TinkerTechLLC/MBML_control_board/mbml.brd

## EAGLE design mbml.brd (2017-07-24)

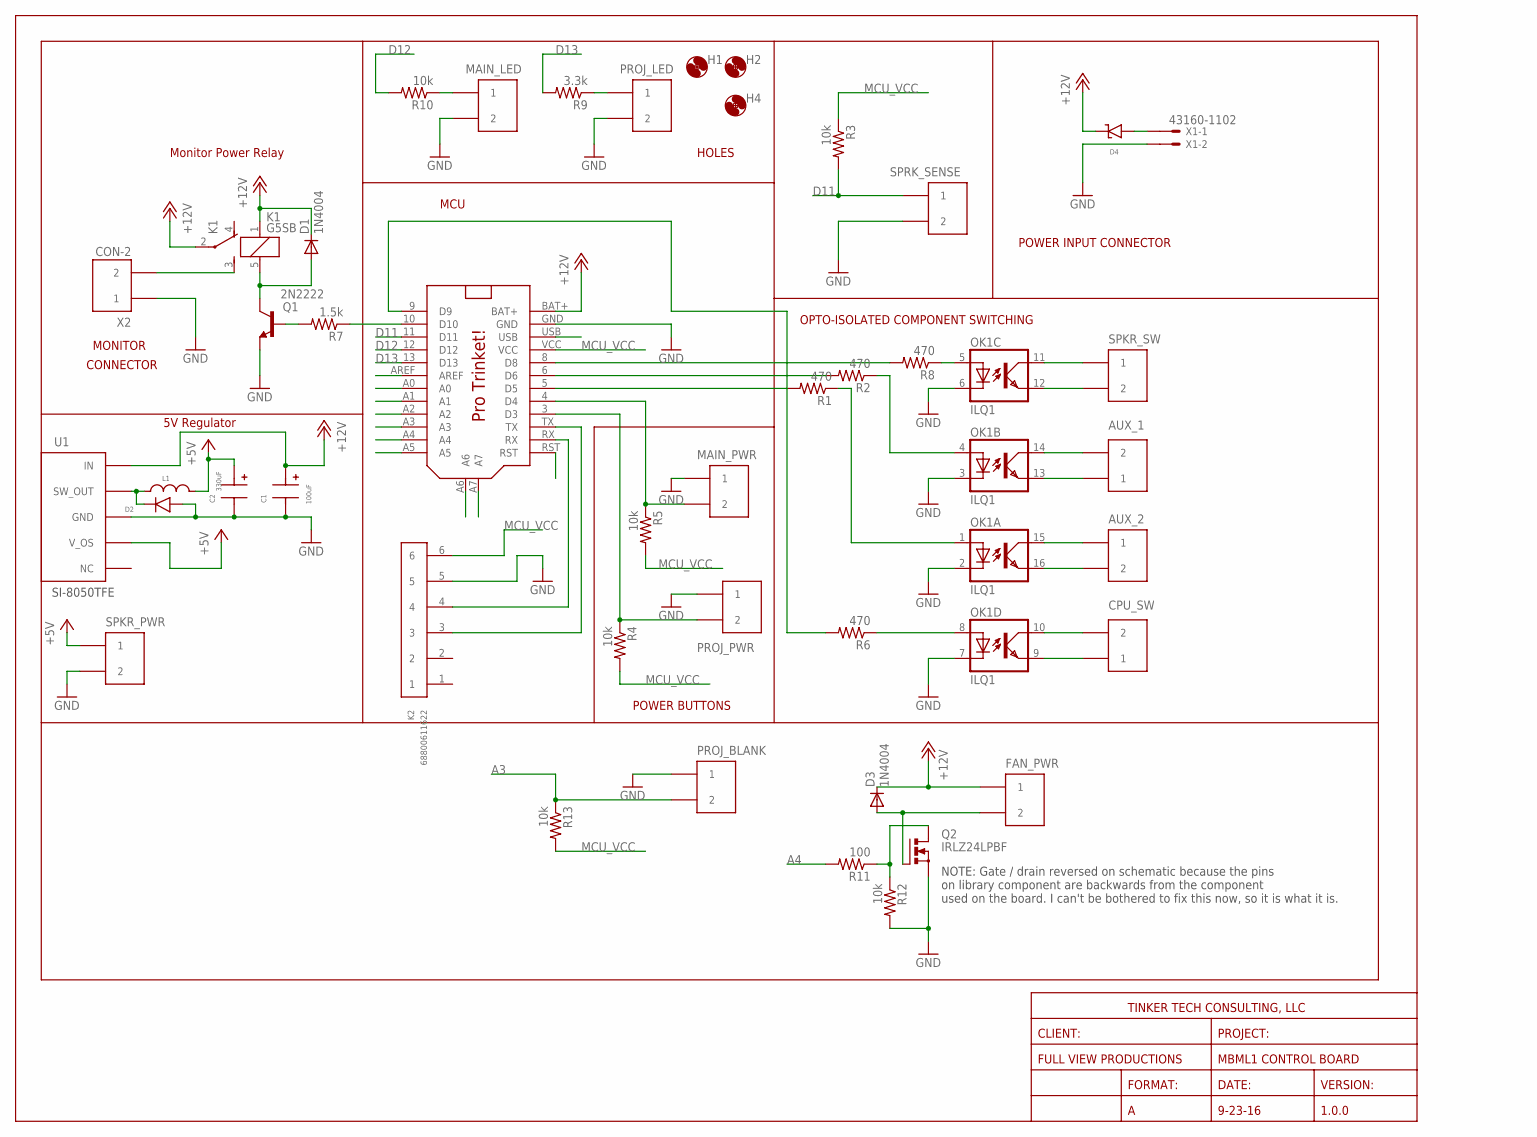
[picture p1: schematic mbml.sch]

Parts:
AUX_1, AUX_2: CON-2B2B-XH-A(LF)(SN); CON_2-2.5MM_TH
C1: 100uF; RADIAL_POL_6.3-DIA_2.5-SPACE
C2: 330uF; RADIAL_POL_10-DIA_5-SPACE
CPU_SW: CON-2B2B-XH-A(LF)(SN); CON_2-2.5MM_TH
D1, D3: 1N4004; DO41-10
D2: DIODE; DO-201AD_AXIAL
D4: DIODE_SHOTTKY; DO-201AD_AXIAL
FAN_PWR: CON-2B2B-XH-A(LF)(SN); CON_2-2.5MM_TH
H1, H2, H4: MOUNT-HOLE3.0; 3,0
K1: G5SB
K2: 68800611622
L1: INDUCTORRADIAL_8.5-DIA_5-SPACE; RADIAL_8.5-DIA_5-SPACE
MAIN_LED: CON-2B2B-XH-A(LF)(SN); CON_2-2.5MM_TH
MAIN_PWR: CON-2B2B-XH-A(LF)(SN); CON_2-2.5MM_TH
OK1: ILQ1; DIL16
PROJ_BLANK: CON-2B2B-XH-A(LF)(SN); CON_2-2.5MM_TH
PROJ_LED: CON-2B2B-XH-A(LF)(SN); CON_2-2.5MM_TH
PROJ_PWR: CON-2B2B-XH-A(LF)(SN); CON_2-2.5MM_TH
Q1: 2N2222; TO18
Q2: IRLZ24LPBF; TO262-V
R1, R2, R6, R8: 470; 0204/5
R3, R4, R5, R10, R12, R13: 10k; 0204/5
R7: 1.5k; 0204/5
R9: 3.3k; 0204/5
R11: 100; 0204/5
SPKR_PWR: CON-2B2B-XH-A(LF)(SN); CON_2-2.5MM_TH
SPKR_SW: CON-2B2B-XH-A(LF)(SN); CON_2-2.5MM_TH
SPRK_SENSE: CON-2B2B-XH-A(LF)(SN); CON_2-2.5MM_TH
U1: REG_5V_SWITCHING_SI-8050E; TO220F-5
U$1: PRO_TRINKET; PROTRINKET
X1: 43160-1102; 43160-XX02
X2: CON-2; MOLEX_MEGA-FIT_2

Connections:
+5V: C2.+, L1.P$2, SPKR_PWR.P$1 (1), U1.4 (V_OS)
+12V: C1.+, D1.C, D3.C, D4.-, FAN_PWR.P$1 (1), K1.1, K1.2, U1.1 (IN), U$1.BAT+
+12V_IN: D4.+, X1.1@1
A0: U$1.A0
A1: U$1.A1
A2: U$1.A2
A3: PROJ_BLANK.P$2 (2), R13.1, U$1.A3
A4: R11.2, U$1.A4
A5: U$1.A5
A6: U$1.A6
A7: U$1.A7
AREF: U$1.AREF
D3: PROJ_PWR.P$2 (2), R4.1, U$1.3 (D3)
D4: MAIN_PWR.P$2 (2), R5.1, U$1.4 (D4)
D5: R1.2, U$1.5 (D5)
D6: R2.2, U$1.6 (D6)
D9: R6.2, U$1.9 (D9)
D10: R7.1, U$1.10 (D10)
D11: R3.2, SPRK_SENSE.P$1 (1), U$1.11 (D11)
D12: R10.2, U$1.12 (D12)
D13: R9.2, U$1.13 (D13)
GND: C1.-, C2.-, D2.+, K2.5, MAIN_LED.P$2 (2), MAIN_PWR.P$1 (1), OK1.2 (C), OK1.3 (C), OK1.6 (C), OK1.7 (C), PROJ_BLANK.P$1 (1), PROJ_LED.P$2 (2), PROJ_PWR.P$1 (1), Q1.1 (E), Q2.3 (S), R12.2, SPKR_PWR.P$2 (2), SPRK_SENSE.P$2 (2), U1.3 (GND), U$1.GND, X1.2@1, X2.P$1 (1)
MCU_VCC: K2.6, R3.1, R4.2, R5.2, R13.2, U$1.VCC
MON_PWR: K1.3 (S), X2.P$2 (2)
unnamed: D2.-, L1.P$1, U1.2 (SW_OUT)
unnamed: OK1.5 (A), R8.1
unnamed: R8.2, U$1.8 (D8)
unnamed: OK1.11 (COL), SPKR_SW.P$1 (1)
unnamed: OK1.12 (EMIT), SPKR_SW.P$2 (2)
unnamed: PROJ_LED.P$1 (1), R9.1
unnamed: OK1.4 (A), R2.1
unnamed: OK1.1 (A), R1.1
unnamed: D3.A, FAN_PWR.P$2 (2), Q2.2 (G)
unnamed: Q2.1 (D), R11.1, R12.1
unnamed: MAIN_LED.P$1 (1), R10.1
unnamed: AUX_1.P$2 (2), OK1.14 (COL)
unnamed: AUX_1.P$1 (1), OK1.13 (EMIT)
unnamed: CPU_SW.P$2 (2), OK1.10 (COL)
unnamed: AUX_2.P$1 (1), OK1.15 (COL)
unnamed: AUX_2.P$2 (2), OK1.16 (EMIT)
unnamed: OK1.8 (A), R6.1
unnamed: CPU_SW.P$1 (1), OK1.9 (EMIT)
RST: U$1.RST
RX: K2.4, U$1.RX
TRANS_BASE: Q1.2 (B), R7.2
TRANS_COLLECTOR: D1.A, K1.5 (2), Q1.3 (C)
TX: K2.3, U$1.TX
USB: U$1.USB

Notes on the sheet:
MCU
HOLES
Monitor Power Relay
POWER INPUT CONNECTOR
OPTO-ISOLATED COMPONENT SWITCHING
POWER BUTTONS
FULL VIEW PRODUCTIONS
MBML1 CONTROL BOARD
PROJECT:
CLIENT:
TINKER TECH CONSULTING, LLC
VERSION:
1.0.0
DATE:
9-23-16
FORMAT:
MONITOR
CONNECTOR
5V Regulator
SI-8050TFE
NOTE: Gate / drain reversed on schematic because the pins on library component are backwards from the component used on the board. I can't be bothered to fix this now, so it is what it is.

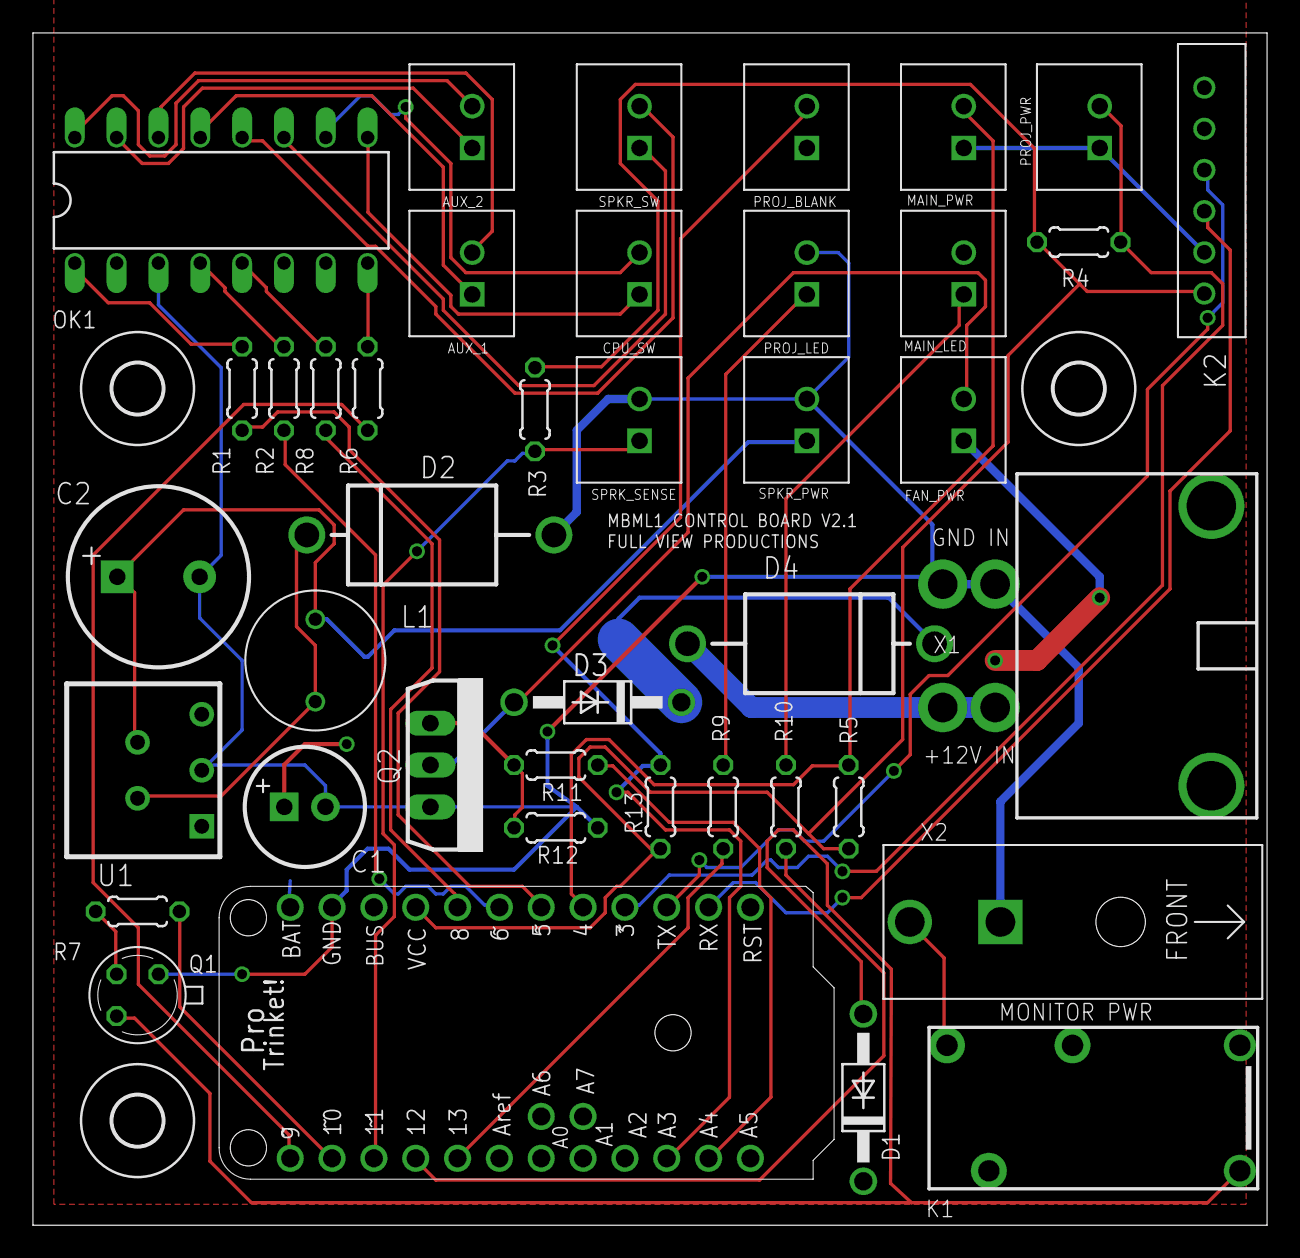
[picture p2: board mbml.brd from above]

Board: 2 copper layers, 74.9 x 72.4 mm, 44 parts (0 on the bottom side), 39 nets.
