TinkerTechLLC/MBML_control_board/(commit log)

2016-11-22 Finished board
    [mbml.brd, mbml.sch]
2017-03-24 Version 2.0 Changes
    Added:
    - 5V regulator
    - Speaker power connector
    - Fan power connector
    - Fan power photocoupler
    Fixed:
    - Missing monitor relay transistor base current limiting resistor
    - Changed power button resistors from pull down to pull up
    - Increased spacing between MCU pin holes to allow for installation of
    female headers
    - Added more GND test vias
    - Added +12V and +5V test via
    [mbml.brd, mbml.sch]
2017-03-24 Added missing resistor silkscreen name
    [mbml.brd]
2017-04-07 Starting major overhaul
    [mbml.brd, mbml.sch]
2017-04-08 Ready for production
    Hopefully…
    [mbml.brd, mbml.sch]
2017-04-08 Fixed stray unconnected trace
    [mbml.brd]
2017-05-08 Version 2.1, DRC OK
    [mbml.brd, mbml.sch]
2017-05-08 Added reverse polarity protection
    [mbml.brd, mbml.sch]
2017-05-23 Changed wire thickness
    [mbml.brd]
2017-06-15 Set correct values for button LED current limiting resistors
    [mbml.brd, mbml.sch]
2017-07-24 MBMLV2.2
    Fixed backwards pins on fan MOSFET, added note about switching 5V
    regulator to a version that supports a higher current draw.
    [mbml.brd, mbml.sch]
