TinkerTechLLC/MBML_control_board/(notices)

Notices in the files:
parts and their libraries:
Wurth_Wire_to_Board_Connectors_rev15d: Copyright: Würth Elektronik
